mimishang/AQ-Monitoring-System/README.md

# AQ-Monitoring-System
Documentation and version control of Mimi Low Cost Air Quality Monitoring System
