mimishang/AQ-Monitoring-System/Documentation/fs2_more_clear.png

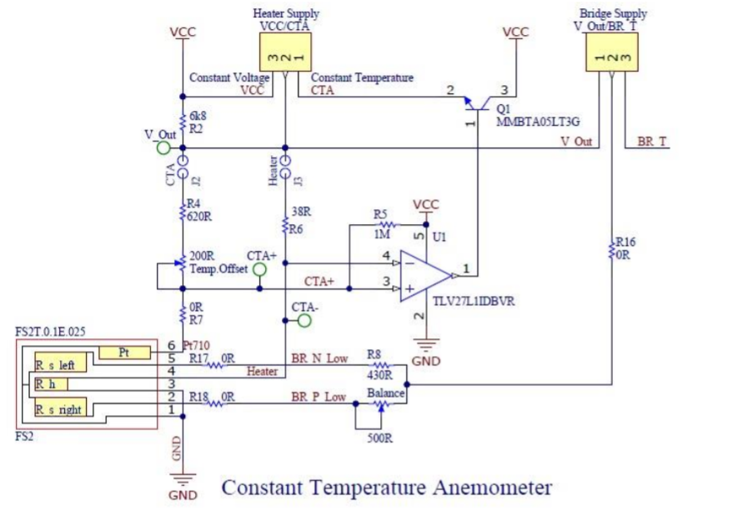
Documentation/fs2_more_clear.png
