mimishang/AQ-Monitoring-System/Documentation/MKRpinout.png

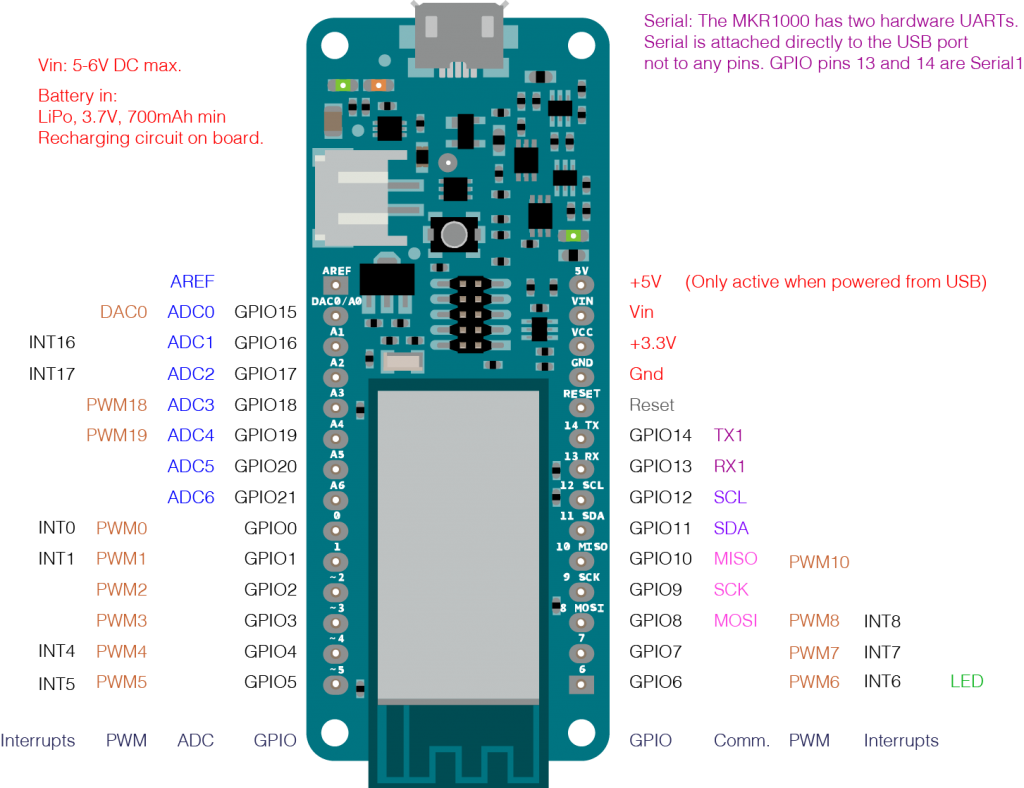
Documentation/MKRpinout.png
