mimishang/AQ-Monitoring-System/PCB/layout_v3_filled.png

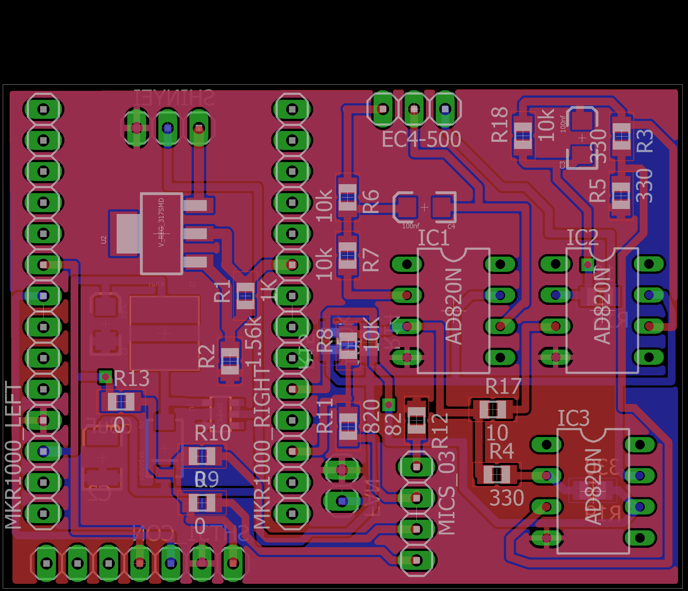
PCB/layout_v3_filled.png
