mimishang/AQ-Monitoring-System/PCB/schematic_v3.png

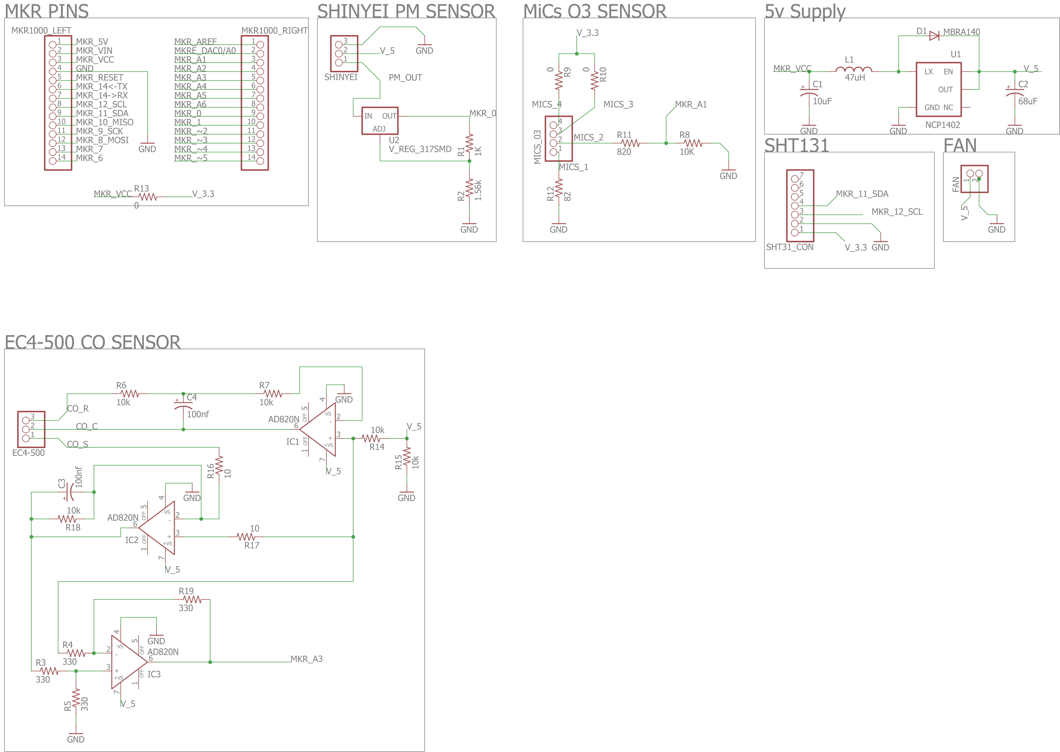
PCB/schematic_v3.png
