mimishang/AQ-Monitoring-System/PCB/Mimi_layout.brd

## EAGLE design PCB/Mimi_layout.brd (2017-05-24)

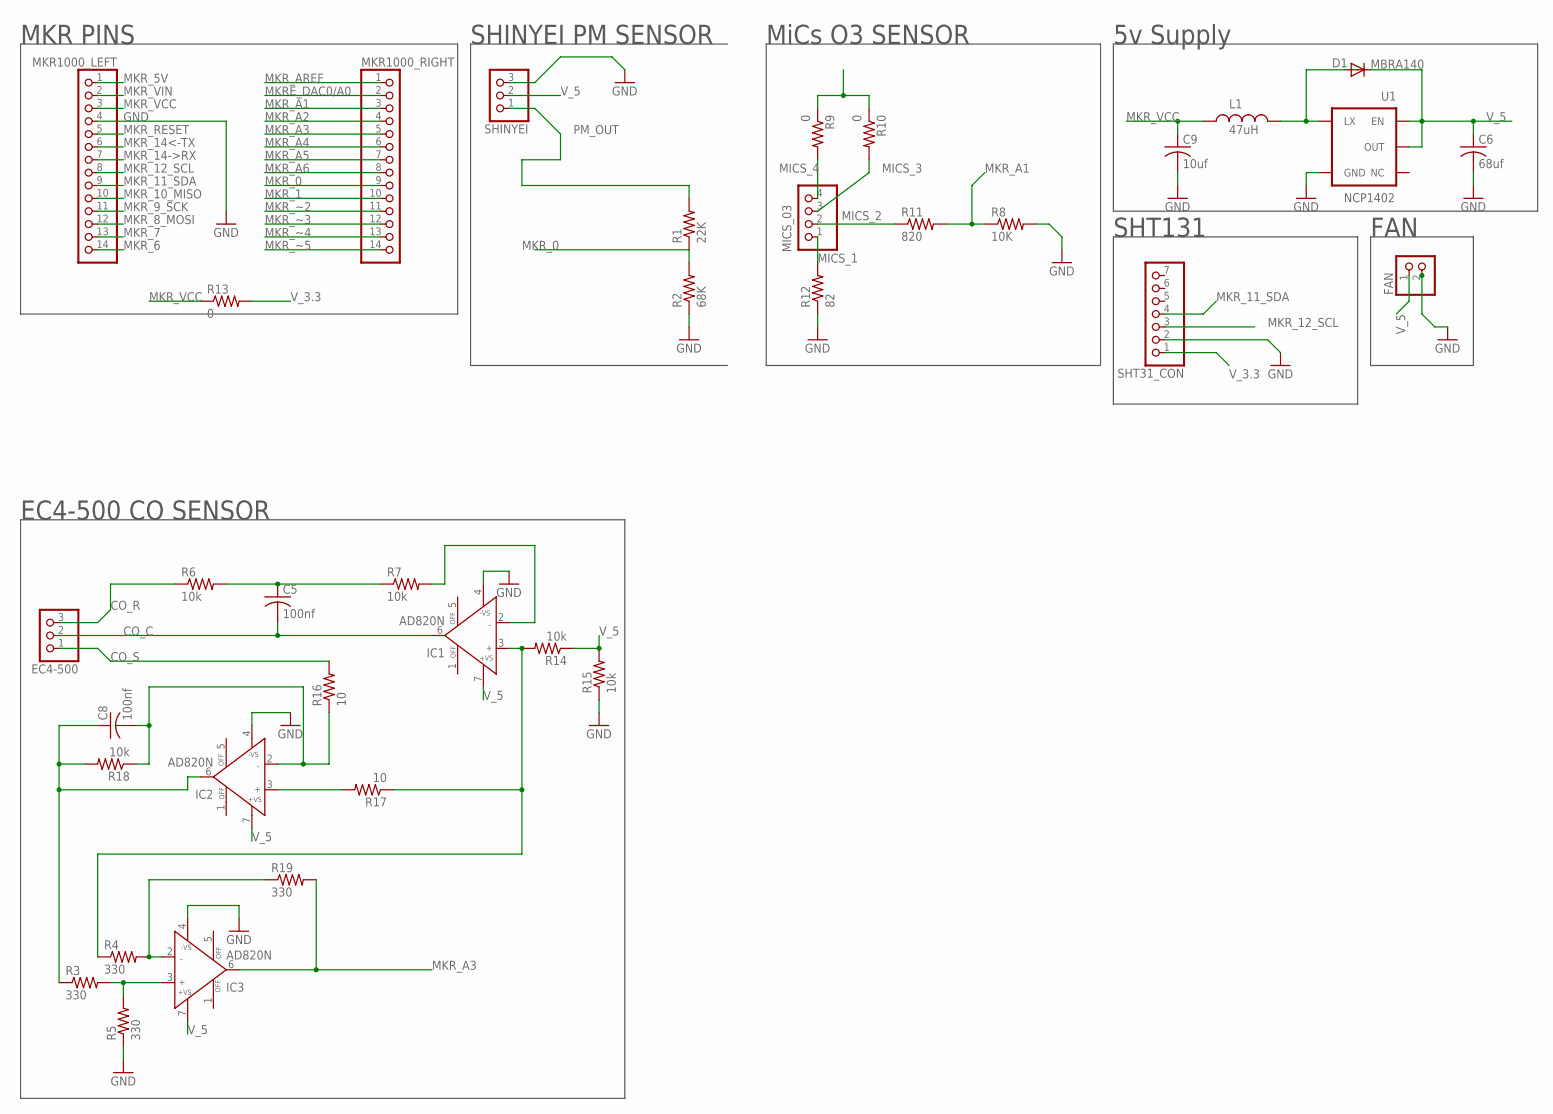
[picture p5: schematic Mimi_layout.sch, sheet 1]

Parts:
C5, C8: 100nf; C0805
C6: 68uf; C0805
C9: 10uf; C0805
D1: MBRA140; SMA-DIODE
EC4-500: PINHD-1X3; 1X03
FAN: PINHD-1X2; 1X02
IC1, IC2, IC3: AD820N; DIL08
L1: 47uH; CR54
MICS_03: PINHD-1X4; 1X04
MKR1000_LEFT, MKR1000_RIGHT: PINHD-1X14; 1X14
R1: 22K; R0805
R2: 68K; R0805
R3, R4, R5, R19: 330; R0805
R6, R7, R14, R15, R18: 10k; R0805
R8: 10K; R0805
R9, R10, R13: 0; R0805
R11: 820; R0805
R12: 82; R0805
R16, R17: 10; R0805
SHINYEI: PINHD-1X3; 1X03
SHT31_CON: PINHD-1X7; 1X07
U1: NCP1402; SOT23-5

Connections:
CO_C: C5.2, EC4-500.2, IC1.6 (OUT)
CO_R: EC4-500.3, R6.1
CO_S: EC4-500.1, R16.2
GND: C6.2, C9.2, FAN.2, IC1.4 (-VS), IC2.4 (-VS), IC3.4 (-VS), MKR1000_LEFT.4, R2.1, R5.1, R8.2, R12.1, R15.1, SHINYEI.3, SHT31_CON.2, U1.4 (GND)
MICS_1: MICS_03.1, R12.2
MICS_2: MICS_03.2, R11.1
MICS_3: MICS_03.3, R10.2
MICS_4: MICS_03.4, R9.2
MKRE_DAC0/A0: MKR1000_RIGHT.2
MKR_0: MKR1000_RIGHT.9, R1.1, R2.2
MKR_1: MKR1000_RIGHT.10
MKR_5V: MKR1000_LEFT.1
MKR_6: MKR1000_LEFT.14
MKR_7: MKR1000_LEFT.13
MKR_8_MOSI: MKR1000_LEFT.12
MKR_9_SCK: MKR1000_LEFT.11
MKR_10_MISO: MKR1000_LEFT.10
MKR_11_SDA: MKR1000_LEFT.9, SHT31_CON.4
MKR_12_SCL: MKR1000_LEFT.8, SHT31_CON.3
MKR_14->RX: MKR1000_LEFT.7
MKR_14<-TX: MKR1000_LEFT.6
MKR_A1: MKR1000_RIGHT.3, R8.1, R11.2
MKR_A2: MKR1000_RIGHT.4
MKR_A3: IC3.6 (OUT), MKR1000_RIGHT.5, R19.2
MKR_A4: MKR1000_RIGHT.6
MKR_A5: MKR1000_RIGHT.7
MKR_A6: MKR1000_RIGHT.8
MKR_AREF: MKR1000_RIGHT.1
MKR_RESET: MKR1000_LEFT.5
MKR_VCC: C9.1, L1.P$1 (1), MKR1000_LEFT.3, R13.1
MKR_VIN: MKR1000_LEFT.2
MKR_~2: MKR1000_RIGHT.11
MKR_~3: MKR1000_RIGHT.12
MKR_~4: MKR1000_RIGHT.13
MKR_~5: MKR1000_RIGHT.14
unnamed: D1.A, L1.P$2 (2), U1.5 (LX)
unnamed: C5.1, R6.2, R7.1
unnamed: IC1.3 (IN+), R4.1, R14.2, R17.1
unnamed: IC1.2 (IN-), R7.2
unnamed: IC2.3 (IN+), R17.2
unnamed: C8.2, IC2.2 (IN-), R16.1, R18.1
unnamed: C8.1, IC2.6 (OUT), R3.1, R18.2
unnamed: IC3.3 (IN+), R3.2, R5.2
unnamed: IC3.2 (IN-), R4.2, R19.1
PM_OUT: R1.2, SHINYEI.1
V_3.3: R13.2, SHT31_CON.1
V_5: C6.1, D1.C, FAN.1, IC1.7 (+VS), IC2.7 (+VS), IC3.7 (+VS), R9.1, R10.1, R14.1, R15.2, SHINYEI.2, U1.1 (EN), U1.2 (OUT)

Notes on the sheet:
EC4-500 CO SENSOR
MiCs O3 SENSOR
SHINYEI PM SENSOR
MKR PINS
SHT131
FAN
5v Supply

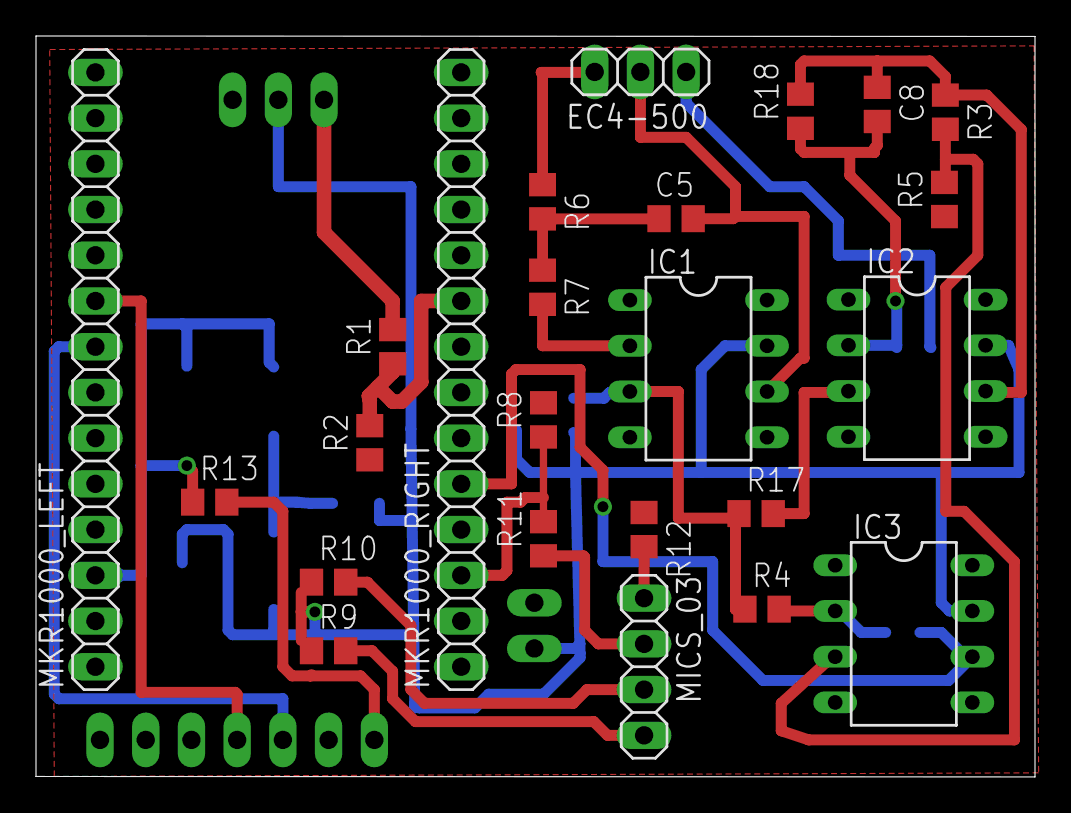
[picture p6: board Mimi_layout.brd from above]

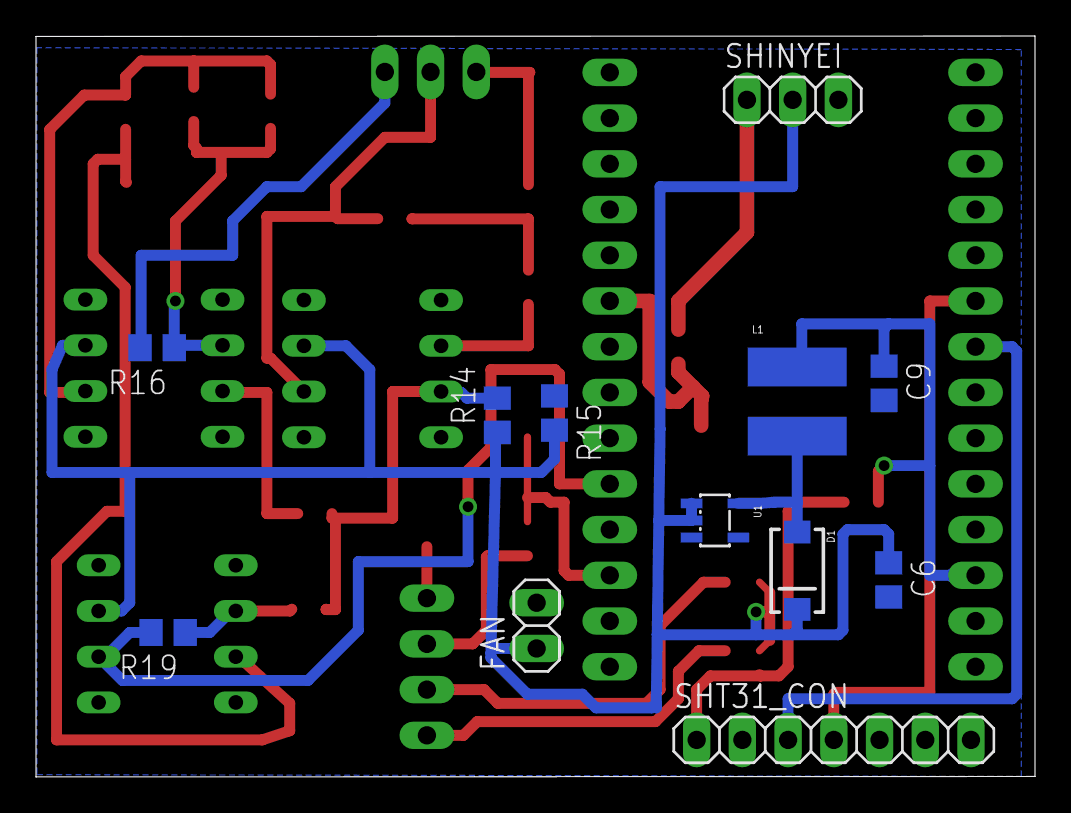
[picture p7: board Mimi_layout.brd from below]

Board: 2 copper layers, 55.5 x 41.2 mm, 36 parts (12 on the bottom side), 26 nets.
