mimishang/AQ-Monitoring-System/Code/SHT31test/SHT31test.ino

/*************************************************** 
  This is an example for the SHT31-D Humidity & Temp Sensor

  Designed specifically to work with the SHT31-D sensor from Adafruit
  ----> https://www.adafruit.com/products/2857

  These sensors use I2C to communicate, 2 pins are required to  
  interface
 ****************************************************/
 
#include <Arduino.h>
#include <Wire.h>
#include "Adafruit_SHT31.h"
Adafruit_SHT31 sht31 = Adafruit_SHT31();

#define TIME_HEADER  "T"   // Header tag for serial time sync message
#define TIME_REQUEST  7    // ASCII bell character requests a time sync message 

#if defined(ARDUINO_ARCH_SAMD)
// for Zero, output on USB Serial console, remove line below if using programming port to program the Zero!
   #define Serial SerialUSB
#endif

void setup() {
#ifndef ESP8266
  while (!Serial);     // will pause Zero, Leonardo, etc until serial console opens
#endif
  Serial.begin(9600);
  Serial.println("SHT31 test");
  if (! sht31.begin(0x44)) {   // Set to 0x45 for alternate i2c addr
    Serial.println("Couldn't find SHT31");
    while (1) delay(1);
  }
}


void loop() {
  float t = sht31.readTemperature();
  float h = sht31.readHumidity();

  if (! isnan(t)) {  // check if 'is not a number'
    Serial.print("Temp="); Serial.print(t); Serial.print(",");
  } else { 
    Serial.println("Failed to read temperature");
  }
  
  if (! isnan(h)) {  // check if 'is not a number'
    Serial.print("Hum = "); Serial.print(h); Serial.println(",");
  } else { 
    Serial.println("Failed to read humidity");
  }
  //Serial.println();
  delay(1000);
}
