mimishang/AQ-Monitoring-System/(commit log)

2017-04-19 board V1
    [Mimi_layout.brd, Mimi_layout.sch]
2017-04-19 Layout V2
    [Mimi_layout.brd, Mimi_layout.sch]
2017-04-19 Board V3
    Version 3 of the schematic and board. might be able to shrink a little more but everything is pretty tight as is.
    Also added EPL LPKF CAM/DRU files for making GBRs for manufacturing and ensuring the layout does not violate machine tolerances
    [Mimi_layout.brd, Mimi_layout.sch]
2017-04-19 screenshots
    Thought some screengrabs of the schematic and layout would be nice
2017-04-19 ozone sensor test program
2017-04-19 PM sensor test program
2017-04-19 previously uploaded the wrong code
    [PMtest.ino]
2017-04-19 Add files via upload
    This is the actual code that will be run on the MKR that is to be inserted into the PCBs.
    it currently has a few bugs and variable names aren't great since its basically an extended version of a pushingbox API test that was done to make sure data could be sent to a google sheets document. i haven't changed all the names yet since it means tweaking them in google sheets, pushingbox, and the code which is a lot of places where things can go wrong. fixing variable names/API names will be one of the last steps i plan to take.
    [AQmonitorV1.ino]
2017-04-19 fixed serial print info
    the names are right at least, still need to make the formatting better
    [AQmonitorV1.ino]
2017-04-19 PPM sensor datasheet
2017-04-19 Flow Sensor Datasheet
2017-04-19 CO sensor schematic
2017-04-19 CO sensor Datasheet
2017-04-19 more CO sensor schematic information
2017-04-19 clearer flow sensor schematic
    it was hard to tell what pins went where from the datasheet schematic, this makes things much clearer
2017-04-19 more FS2 information
    manual for a whole PCB built around the FS2 flow sensor
2017-04-19 many small fixes
    Can connect to PSU unsecured wifi now!
    better output formatting.
    for some reason the program hangs when it tries to access the SHT31.
    data received from PM sensor seems questionable (outputs 0 always)
    [AQmonitorV1.ino]
2017-04-21 compression & schematic fixes
    board dimensions shrunk to 2.18 * 1.62. will try to compress further but from this point on there will be diminishing returns on time spent vs resulting compression.
    also fixed a few warnings in schematic capture mode. there are still some but none are serious problems.
    [Mimi_layout.brd, Mimi_layout.sch]
2017-04-21 small fixes
    removed a couple more DRC errors
2017-04-21 Partlist
    has a list of all the parts in the schematic and layout. its worth noting that the opamps being used are different since eagle had a library with a component of the same dimensions. I'll make a spreadsheet with links and prices soon.
2017-04-26 better names, first in a series of updates
    after a series of failures i have began to take a more systematic approach to fixing the naming of the stuff that allows the MKR to talk to pushingbox and google spreadsheets. step 1 was updating the variable names being used in the arduino sketch to be more human readable. this code has been tested and absolutely sends the right data to the right spreadsheet (yay!)
    [AQmonitorV1.ino]
2017-05-05 capacitor fix
    removed oversize capacitors (1206) and replaced with 0805s
    [Mimi_layout.brd, Mimi_layout.sch]
2017-05-24 small fixes
    switched a couple values from int to float to allow higher resolution readings, changed port configuration to an input
    [AQmonitorV1.ino]
2017-05-24 replaced components, rerouted
    a few components were removed and resistances changed in accordance with observed device behavior
    [Mimi_layout.brd, Mimi_layout.sch]
